risclite/SuperScalar-RISCV-CPU/wiki/png/ProjBuffer.PNG

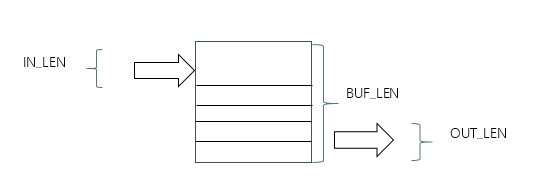
wiki/png/ProjBuffer.PNG
