risclite/SuperScalar-RISCV-CPU/(commit log)

2019-10-01 para method changes
2019-10-28 To keep every skipped OP has its seat in RFBUF.
    [schedule.v]
2020-05-07 Rd of store instructions should be 0, imm5 is extracted wrongly.
    [alu.v]
